ard-wc/kfpd/Hardware/Pictures/Touch Detection Circuit With Multiplexer_Slate.png

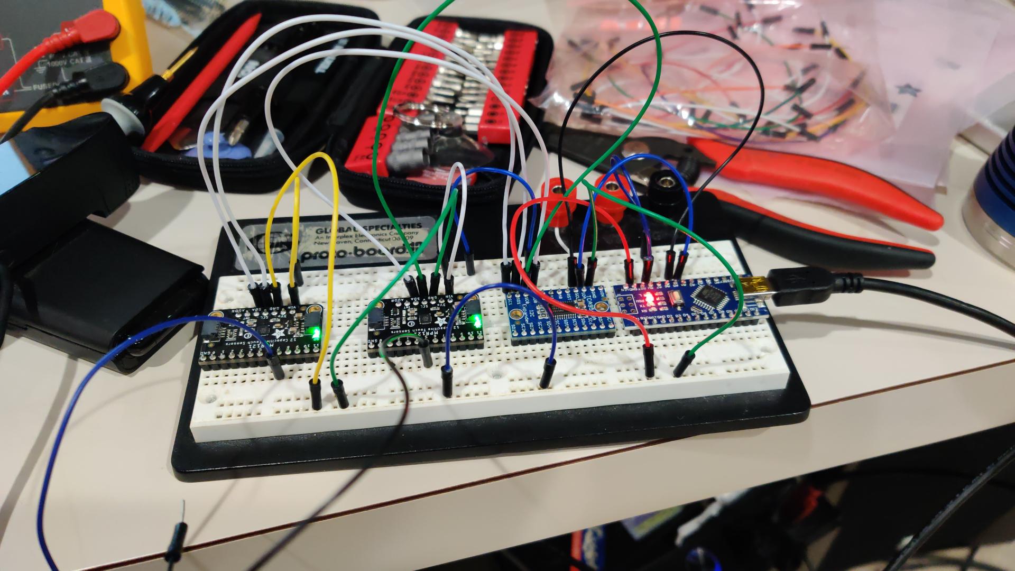
Hardware/Pictures/Touch Detection Circuit With Multiplexer_Slate.png
