ard-wc/kfpd/Hardware/Pictures/Keyboard Case Unmodified_Slate.png

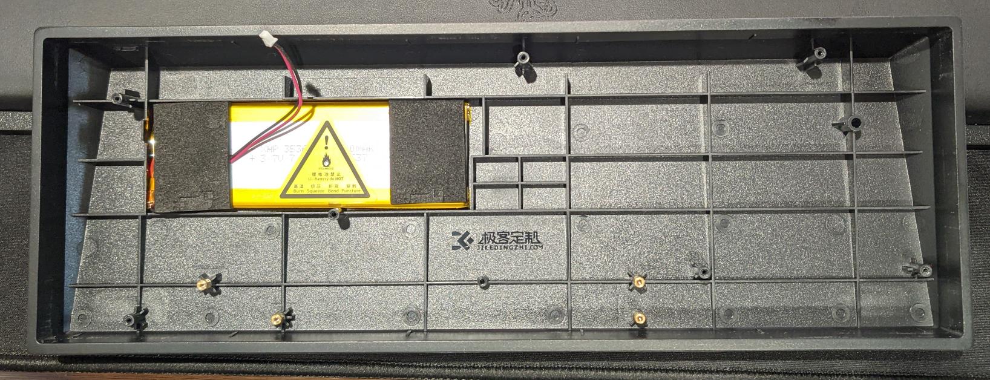
Hardware/Pictures/Keyboard Case Unmodified_Slate.png
