ard-wc/kfpd/README.md

## Table of Contents

Block Diagram

- Keyboard Finger Position Display Block Diagram\_Victor.pdf

Code of Conduct

- EE585-595 Code of Conduct.pdf

Conductive Materials

- Pros and Cons of Different Conductive Materials_Victor_Slate_Chase.pdf

Hardware

- Compartment Sketches &amp; Dimensioning
  - Compartment Design #1 - Victor Siooh.glb
  - Compartment Design #1 - Victor Siooh.png
  - Compartment Design #2 - Victor Siooh.glb
  - Compartment Design #2 - Victor Siooh.png
  - Compartment Design Work\_Victor.pdf
- Components &amp; Datasheets
  - Component_List_Slate.xlsx
  - Component_List_Slate.pdf
  - MPR121\_Technical\_Data\_2010.pdf
  - MPR121\_Technical\_Data\_2013.pdf
  - NanoV3.3\_sch.pdf
  - TCA9548\_Datasheet.pdf
- Pictures
  - Keyboard Case Modified_Slate.png
  - Keyboard Case Unmodified_Slate.png
  - Touch Detection Circuit With Multiplexer_Slate.png
  - Touch Detection Circuit Without Multiplexer_Chase.jpg
- Schematics
  - Official\_Schematic\_KFPD\_Slate.pdf
  - Prototype Schematic\_Victor.pdf
- Testing
  - Combined Data for Testing ADC Counts\_Chase.xlsx
  - Test ADC counts just with 25 ohms\_Chase.csv
  - Test ADC counts just with 50 ohms\_Chase.csv
  - Test ADC counts just with finger\_Chase.csv

Presentations

- Senior Project Design I - Fall Showcase Technical Presentation.pptx
- Senior Project Design I - TechBlazers Midterm Presentation.pptx
- Senior Design Project I Fall Showcase Orientation Video Presentation.pptx

Product Reflection

- Product Reflection Paper - Techblazers.pdf

Project Planning

- Project Planning Paper.pdf

Project Proposal

- Project Proposal.pdf

Prototype Images

- Prototype.jpg
- Hardware Integration (MPR121 Capacitive Touch Sensors and Arduino Nano).jpg

Requirements
- Technical Requirements.pdf

Software

- Application\_Prototype\_Emmitt.py
- Application\_Test\_Emmitt.py
- FrontEndDev\_Chief.pdf
- KFPDapp\_Chief.py
- MPR121_Final.ino
- MPR121\_Multiplexer\_Chase.ino
- MPR121\_print\_ADC\_counts\_Chase.ino
- MPR121\_test\_sensitivity\_Chase.ino
- resize\_test\_Emmitt.py

Specifications

- Technical Product Specifications.pdf

Team Skills

- Team Skills Matrix.xlsx

Technical Journals

- Chase
  - Technical Journal - Senior Design 1\_Chase.pdf
  - Technical Journal - Senior Design 2\_Chase.pdf
- Chief
  - IndividualJournalFall21Chief.pdf
  - TechJournalSDII.pdf
- Emmitt
  - journal2.pdf4
- Slate
  - Individual Technical Journal.pdf
- Victor
  - Journal Entry #1.pdf
  - Journal Entry #2.pdf
  - Journal Entry #3.pdf
  - Journal Entry #4.pdf
  - Journal Entry #5.pdf
  - Journal Entry #6.pdf
  - Journal Entry (01_24_22 – 02_06_22).pdf
  - Journal Entry (02_13_22 - 02_27_22).pdf

Videos
  - Prototype Demonstration Video.mp4
  - Product Orientation Video.mp4

Weekly Minutes
  - EE585-595\_weekly minutes (09\_05\_21).docx
  - EE585-595\_weekly minutes (09\_12\_21).docx
  - EE585-595\_weekly minutes (09\_19\_21).docx
  - EE585-595\_weekly minutes (09\_26\_21).docx
  - EE585-595\_weekly minutes (10\_03\_21).docx
  - EE585-595\_weekly minutes (10\_31\_21).docx
  - EE585-595\_weekly minutes (11\_14\_21).docx
  - EE585-595_weekly minutes_02_06_22.docx
  - EE585-595_weekly minutes_02_20_22.docx

Work Packages (Individual)
  - Work Package_Slate.pdf
  - Individual Work Package - Victor Siooh.pdf
  - Individual_Work_Statment_Emmitt.pdf
  - Work Package_Chase.pdf
  - IndividualWorkPackage_Chief.pdf

Work Statement
  - Senior Design Project II - 2nd Semester Work Statement.pdf
