ard-wc/kfpd/Project Completion/Deliverables/Wire Connections Between Hardware Devices.pdf

The connections between the devices are outlined below.
- Vin
o Connect all sensors and multiplexer to 5V node from Arduino Nano
- GND
o GND on multiplexer goes to GND on Nano all the capacitive sensors are connected to
- SDA
o SDA on multiplexer connects to A4 on Nano
- SCL
o SCL on multiplexer connects to A5 on Nano
- SDN
o Connect SDN on the first three sensors to SD0 on the multiplexer
o Connect SDN on the second three sensors to SD1 on the multiplexer
- SCN
o Connect SCN on the first three sensors to SC0 on the multiplexer
o Connect SCN on the second three sensors to SC1 on the multiplexer
