ard-wc/kfpd/Hardware/Schematics/Prototype Schematic_Victor.pdf

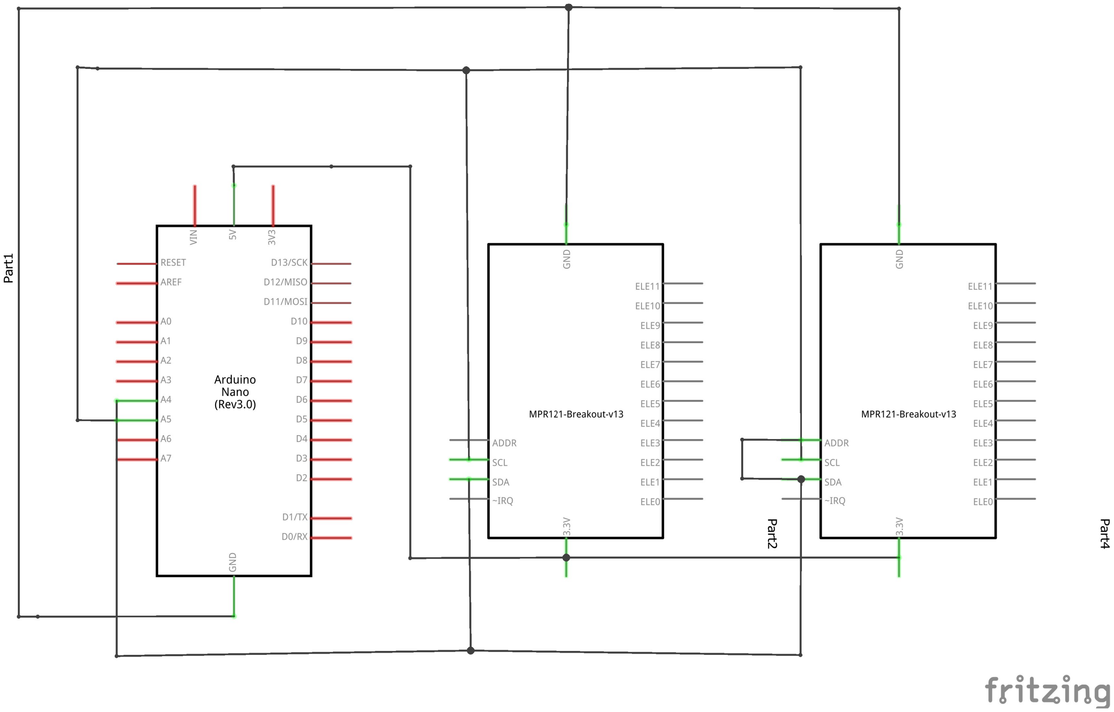
[picture p15: figure]
