ard-wc/kfpd/Hardware/Compartment Sketches & Dimensioning/Compartment Design #2 - Victor Siooh.png

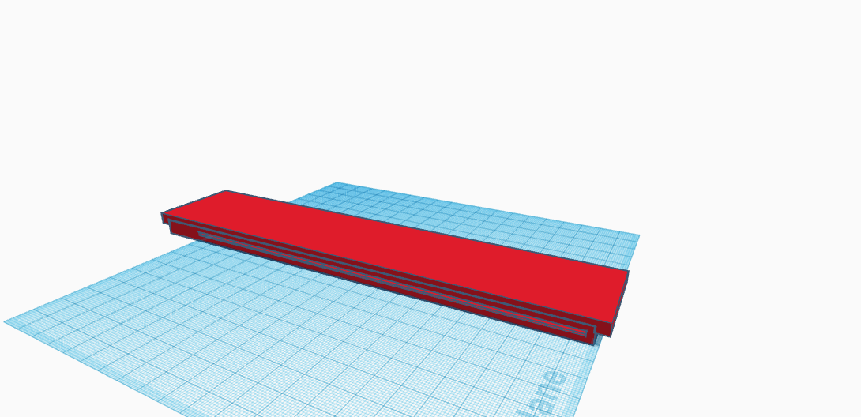
Hardware/Compartment Sketches & Dimensioning/Compartment Design #2 - Victor Siooh.png
