ard-wc/kfpd/Hardware/Pictures/Keyboard Case Modified_Slate.png

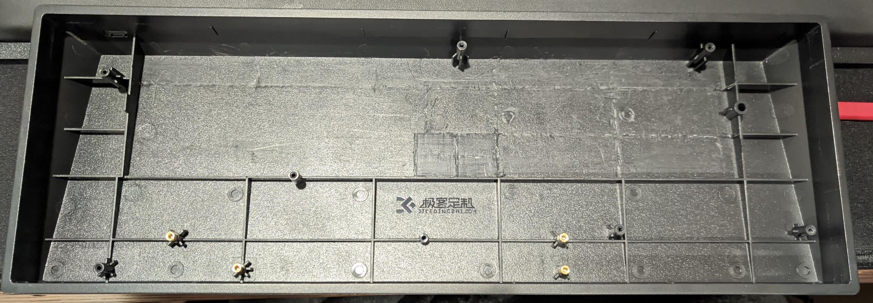
Hardware/Pictures/Keyboard Case Modified_Slate.png
