ard-wc/kfpd/Project Completion/Deliverables/Compartment Design #1 - Victor Siooh.png

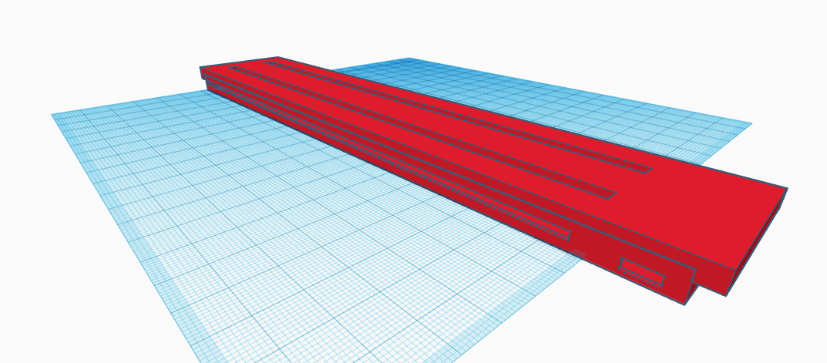
Project Completion/Deliverables/Compartment Design #1 - Victor Siooh.png
