ard-wc/kfpd/Prototype Images/Hardware Integration (MPR121 Capacitive Touch Sensors and Arduino Nano).jpg

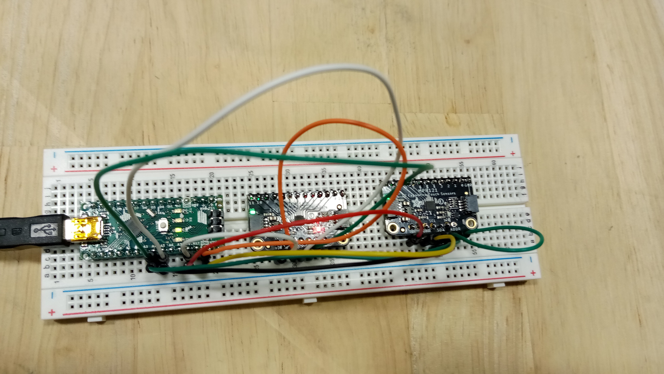
Prototype Images/Hardware Integration (MPR121 Capacitive Touch Sensors and Arduino Nano).jpg
