ard-wc/kfpd/Prototype Images/Prototype.jpg

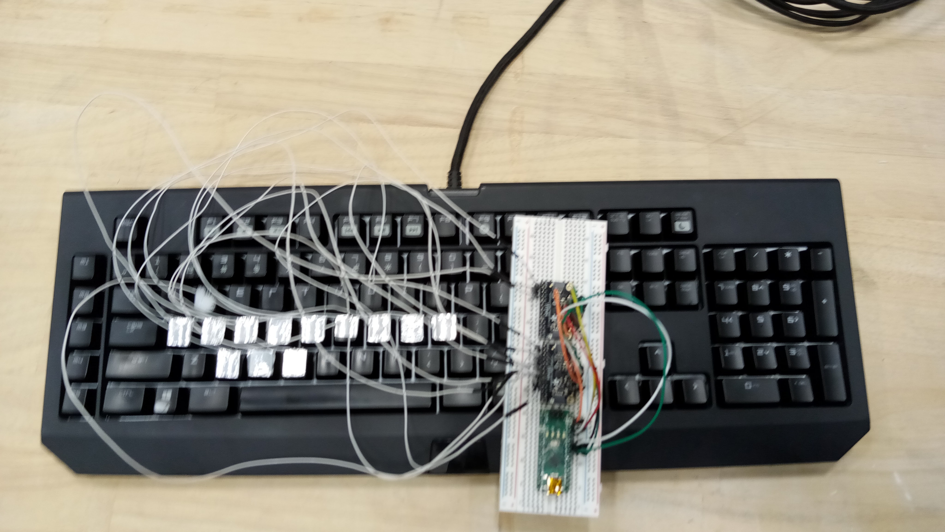
Prototype Images/Prototype.jpg
