ard-wc/kfpd/Project Completion/Deliverables/Component_List_Slate.pdf

Component Description | Model Number | Manufacturer Quantity
12-Key Capacitive Touch Sensor | MPR121 | Adafruit | 6
I2C Multiplexer | TCA9548A | Adafruit | 1
Microcontroller | ATmega328 (Nano) | Arduino | 1
Switches | ks-9 brown | Gateron | 63
Keyboard (Case and PCB) | GK61xs | Skylong | 1
I2C Qwiic Conectors | JST SH 4-pin | Adafruit | 6
Conductive Coating Silver/Copper | 843AR | MG Chemicals | 1
30AWG Silicone Wire | N/A | BNTECHGO | 61 (wires)
Keycaps | Black 104/105 | Razer | 1
