ard-wc/kfpd/Project Completion/Deliverables/KeyPressTestCase.docx

Document will show a table indicating available keys on the keyboard, and whether the correct key was shown in the on-screen keyboard when pressed on.

Key | Pass/Fail | Key | Pass/Fail
Esc | Pass | D | Pass
1 | Pass | F | Pass
2 | Pass | G | Pass
3 | Pass | H | Pass
4 | Pass | J | Pass
5 | Pass | K | Pass
6 | Pass | L | Pass
7 | Pass | ; | Pass
8 | Pass | ‘ | Pass
9 | Pass | Enter | Pass
0 | Pass | Shift (Left side) | Pass
- | Pass | Z | Pass
= | Pass | X | Pass
Backspace | Pass | C | Pass
Tab | Pass | V | Pass
Q | Pass | B | Pass
W | Pass | N | Pass
E | Pass | M | Pass
R | Pass | , | Pass
T | Pass | . | Pass
Y | Pass | / | Pass
U | Pass | Shift (Right side) | Pass
I | Pass | Ctrl (Left side) | Pass
O | Pass | Win | Pass
P | Pass | Alt (Left side) | Pass
[ | Pass | Spacebar | Pass
] | Pass | Alt (Right side) | Pass
\ | Pass | Menu | Pass
Caps Lock | Pass | Ctrl (Right side) | Pass
A | Pass | Fn | Pass
S | Pass
