ard-wc/kfpd/Project Completion/Deliverables/Combined Data for Testing ADC Counts_Chase.xlsx

Sheet: Data Summary
Added Resistance | Average Baseline ADC counts (No Touch) | Average Filter ADC counts (No Touch) | Difference (No Touch) | Average Baseline ADC counts (Touch) | Average Filter ADC counts (Touch) | Difference (Touch) | Average Baseline ADC counts (Touch-No Touch) | Average Filter ADC counts (Touch-No Touch)
50 ohms | 224 | 226 | 2 | 222 | 59 | 163 | 2 | 167
25 ohms | 236 | 236 | 0 | 235 | 52 | 183 | 1 | 184
0 ohms | 278 | 282 | 4 | 276 | 60 | 216 | 2 | 222

Sheet: 50 ohms
ID | ADC Value
3b | 224
3f | 225
3b | 224
3f | 227
3b | 224
3f | 225
3b | 224
3f | 227
3b | 224
3f | 226
3b | 224
3f | 227
3b | 224
3f | 225
3b | 224
3f | 226
3b | 224
3f | 226
3b | 224
3f | 224
3b | 224
3f | 224
3b | 220
3 | 1
3f | 58
3b | 220
3f | 58
3b | 220
3f | 59
3b | 220
3f | 57
3b | 220
3f | 55
3b | 220
3f | 57
3b | 220
3f | 57
3b | 220
3f | 52
3b | 220
3f | 55
3b | 220
3f | 53
3b | 220
3f | 53
3b | 220
3f | 56
3b | 220
3f | 58
3b | 224
3 | 0
3f | 226
3b | 224
3f | 225
3b | 224
3f | 226
3b | 224
3f | 227
3b | 224
3f | 226
3b | 224
3f | 226
3b | 224
3f | 225
3b | 224
3f | 227
3b | 224
3f | 226
3b | 224
3f | 225
3b | 224
3f | 226
3b | 224
3f | 226
3b | 224
3f | 225
3b | 224
3f | 226
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
