ard-wc/kfpd/Technical Journals/Victor/Journal Entry #3.pdf

Journal Entry #3 (09/27 – 10/01)

Objective: Research over capacitive sensing

Introduction to Capacitive Sensing:

Capacitive Sensors:

How Capacitive Touch Through Metal Works: https://www.youtube.com/watch?v=bokWXzVXsyc&ab_channel=TexasInstruments

This video details some of the benefits of having capacitive touch through metals.

- Touch through metal is apparently waterproof
- Operates well while using gloves
- Dirtproof

Arduino with Capacitive Touch Sensors: https://www.youtube.com/watch?v=Jt2yZMGCQBQ&t=45s&ab_channel=BasonTech

Materials required: Jumper wires, Arduino Uno, and capacitive touch sensors

- Capacitive touch sensors could be integrated to the keyboard beneath the keycaps.
- We would have to figure out how the keyboard would detect the touch sensors as an input
- This option may not be the best aesthetically since so many wires would be used for each key

How Capacitive Touch Screens Works: https://www.youtube.com/watch?v=BR4wNq6WGkg&ab_channel=TomHebb

- C = EA/d
- A capacitor can be made with two conductors

DIY Capacitor: https://www.youtube.com/watch?v=BR4wNq6WGkg&ab_channel=TomHebb

- Homemade capacitor (paper,foil,paper,foil,paper)
- Aluminum and paper are cheap materials to purchase
- Capacitance of our capacitor can be determined using capacitance formula
- We can use aluminum as our conductive plates and

USB Keyboards with Cherry MX Keycaps:

Logitech G610 Orion Red Backlit Mechanical Gaming Keyboard

https://www.amazon.com/Logitech-Backlit-Mechanical-Gaming-Keyboard/dp/B01CDYB8AG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 (https://www.amazon.com/Logitech-Backlit-Mechanical-Gaming-Keyboard/dp/B01CDYB8AG)

Mechanical Gaming Keyboard, MageGee 2021 New Upgraded Blue Switch 104 Keys White Backlit Keyboards, USB Wired Mechanical Computer Keyboard for Laptop, Desktop, PC Gamers(White & Blue)

https://www.amazon.com/Mechanical-Keyboard-MageGee-Upgraded-Keyboards/dp/B087P7153D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 (https://www.amazon.com/Mechanical-Keyboard-MageGee-Upgraded-Keyboards/dp/B087P7153D?s=electronics)

ard+blue&qid=1633312887&s=electronics&sprefix=mechanical+keyboard+b%2Celectronics%2C505&sr= 1-4 (https://www.amazon.com/Mechanical-Keyboard-MageGee-Upgraded-Keyboards/dp/B087P7153D?s=electronics)

Mechanical Gaming Keyboard Full Size, Bllean LED Rainbow Backlit Ultra-Slim Wired Keyboard with Blue Switches, Full-Key Rollover, Ergonomic Water-Resistant USB Keyboard for Windows Mac Gaming

https://www.amazon.com/dp/B09D3DDQ99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 wODg4MjMzMlRDVFgyS0pDU0VQUSZlbmNyeXB0ZWRBZElkPUEwOTk0ODA1OUtKSzRTOEFDR1RaJndpZG dldE5hbWU9c3BfZGV0YWlsJmFjdGlvbj1jbGlja1JlZGlyZWN0JmRvTm90TG9nQ2xpY2s9dHJ1ZQ== (https://www.amazon.com/dp/B09D3DDQ99)

Capacitive Touch Sensing Being Used in Midi Keyboards

https://www.nime.org/proceedings/2012/nime2012_195.pdf
