ard-wc/kfpd/Technical Journals/Slate/Individual Technical Journal.pdf

# Individual Technical Journal

Senior Design

Slate Jordan

## Week of September 5th

-11th

Summary

This week our team struggled to find an idea that met all our criteria. We tentatively decided on my idea for an automatic pothole reporting device, however, more research yielded AI with cameras to be the best approach which doesn’t give our EE team members much hardware work. Considering this we switched to our backup Evergy sponsored idea of QR Code labeling and database integration. Our concerns about not enough work were verified in class and we were back at square one with no project ideas left. Eventually we settled upon an idea from our meeting with the professor.

Focus of the week

This week involved lots of research on various ideas we had. The main problem with my first idea was the work involved for a solution being mostly software which isn’t ideal for our team. Our backup idea was never ideal and was mainly used as a placeholder after we ran out of time between nixing the first idea and presenting on Friday. The current plan is to go with a local license plate scanner and reader which uses the LoRaWAN network to communicate findings back to police stations. Currently I am researching existing solutions commonly called LPR or license plate readers to find out if our solution can be unique enough to differentiate it from existing solutions.

## Week of September 12th

-18th

Summary

We were still struggling with our project idea this week, so the majority of my time was spend researching and thinking about projects. We had multiple team meetings and communication about the validity of ideas. The ALPR (Automatic License Plate Reader) idea was slowly falling apart after much research into existing technologies revealed many solutions already on the market with capabilities that met our requirements.

Research

My research led me to various existing ALPR devices and software. I will use platerecognizer.com as an example. It supports both on-device and cloud software, images, and video, as well as non-ideal angles, lighting, resolution, etc. With all this being considered I concluded that anything we would be able to build with our limited resources and time would not have any competitive advantage with the main aim of our ALPR solution being the ability to read plates at angles.

Some Resources

https://github.com/openalpr/openalpr

https://www.openalpr.com/

https://platerecognizer.com/

## Week of September 19th

-25

th

Summary

Our team was still toying with a few ideas like building a map of traffic and speed cameras using computer vision to give drivers the knowledge of where these controversial traffic cameras are located. Eventually we settled on a keyboard with the ability to detect finger placement. This would in theory speed up the process of learning how to touch type. Our initial idea to enable the sensing of finger placement is capacitively sensitive keycaps. We would also have software to give an on-screen representation of finger placement thus discouraging the habit of looking down at the keyboard. The problem: some people have trouble learning touch typing and breaking the habit of constantly looking down at the keyboard. The solution: A keyboard with touch sensitive keys and an on-screen overlay showing which keys are being touched.

Research/Thoughts

My initial idea on how to sense key touches was to have the keys be capacitive. I thought of the clever Oculus Rift controllers which have capacitively sensitive buttons and triggers to show in a virtual environment where your fingers were currently resting. As is the case with many technologies, the original purpose is not always the best use so with that in mind I am still brainstorming other possible use cases for this extra layer of input being enabled on a keyboard. Another idea for the tracking the position of fingers above the keyboard was some type of sensor(s) to track the x-y position, but we think capacitive keys is the clear first step with that being something to consider later in the development process. Using a keyboard with standard Cherry MX style key caps will allow us to switch keycaps out as we go forward with testing.

Resources

https://www.youtube.com/watch?v=wdgULBpRoXk

https://www.youtube.com/watch?v=mWR9Q_pTagw

https://www.youtube.com/watch?v=bokWXzVXsyc

https://www.nelson-miller.com/capacitive-switch-work/

http://www.pcbheaven.com/wikipages/How_a_Touch_Button_works/?p=1

https://butlertechnologies.com/basics-capacitive-touch/

## Week of September 26th - October 2

nd

Summary

My focus for this week was to find out as much as I could about affordable and small capacitive sensing hardware. Something small enough we could incorporate into a keyboard as well as interface with windows via USB.

Research Findings

An Arduino stood out as the clear choice for microcontroller for all our capacitive inputs and interfacing with the computer. A combination of the broad userbase and resources and hardware addons available for Arduinos make for a nice fit. Specifically, the Arduino nano model is ideal for its small form factor. For the capacitive sensing of so many keys it is impractical to directly attach them to an Arduino. This means some intermediary controller/input device is needed to take all 18 or so inputs. The clear choice for this was the Adafruit 12-Key Capacitive Touch Sensor Breakout - MPR121 for it’s 12 capacitive inputs as well as built in sensitivity adjustment and noise filtering for only $8.

Resources

https://www.adafruit.com/product/1982

https://store.arduino.cc/products/arduino-nano

https://create.arduino.cc/projecthub/gatoninja236/capacitive-touch-sensing-grid-f98144

## Week of October 3

nd
- 9

th

Summary

I didn’t do much in the way of technical research this week with our midterm presentation coming up. I helped work on the presentation as well as brainstorm use cases for our keyboard as well as some routes we could take with the software.

Resources

https://windowtop.info/

https://docs.oracle.com/cd/E19683-01/816-0279/transpoverlay-63475/index.html

https://polycount.com/discussion/89191/image-always-on-top-overlay-software-for-win

https://softwarerecs.stackexchange.com/questions/1767/display-half-transparent-ghostimage-over-other-windows (https://softwarerecs.stackexchange.com/questions/1767/display-half-transparent-ghost-image-over-other-windows)

https://www.mobzystems.com/tools/seethroughwindows/

## Week of October 10th

- 16th

Summary

This week we continued the theme of brainstorming and researching problems or demographics of people which could benefit from our keyboard. I also researched and found a keyboard which met our requirements of price, size, switches, and quality. In addition, I had a breakthrough idea on how to easily operate the Arduino USB connection over the same keyboard cable.

Ideas

In my research on how to easily operate two USB connections over the existing keyboard cable without interfering with standard keyboard operations, I had an idea to easily overcome the challenge. After seeing keyboards with built in USB pass through ports, It was clear that we could start with a keyboard that had a USB pass through port built in. This would allow us to easily tap into the pass through and connect our Arduino via USB with no changes to the existing keyboard design or function.

## Week of October 17th

- 23rd

Summary

My focus for this week was mostly on hardware and getting more specific requirements and specifications. I’ve made the selection of silicone insulated wire for our keyboard wiring due to its high flexibility which should minimize interference with keys. From looking over our keyboard, space inside the chassis is limited so my initial thoughts are we might have to find a different keyboard or modify the bottom plate to make room for our parts. Our team’s technical report was also a big focus for this week and incorporated the research done.

Resources

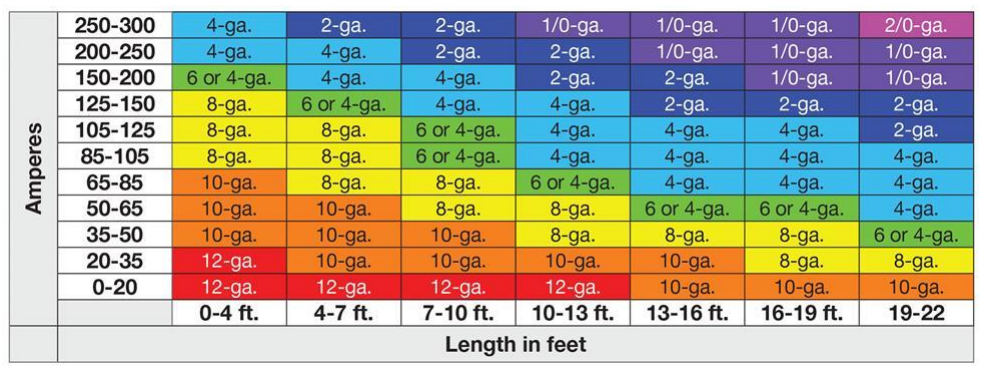
[picture p60: figure]

https://www.ql-custom.com/what-is-silicone-wire-performance-benefits-and-uses-withexamples.html (https://www.ql-custom.com/what-is-silicone-wire-performance-benefits-and-uses-with-examples.html)

https://www.meridiancableassemblies.com/2021/04/wire-gauge-size-guide/

## Week of October 24th

- 30th

Continued the planning of our prototype. Also continued working on other possible uses for the extra layer of input enabled by our capacitively sensitive keys. We continue to have the problem of what the best use case or use market is. One option to enhance the touch typing learning experience with our keyboard is to detect which finger is on a certain key. The ability to distinguish between fingers will allow our program to analyze one’s typing habits and report on how to improve form and in turn increase typing efficiency and speed. This might be enabled by doing an initial calibration for an individual user’s fingers if our capacitive system is sensitive enough to detect the subtle change in capacitances. Another option to enhance this capability would be to incorporate a camera which could augment the capacitive sensors in distinguishing between fingers. VR application is already using a similar type of computer vision to recognize the keyboard and relative hand position, although it is currently not the most accurate which is where our capacitively augmented system would be superior.

## Week of October 31

st

## - November 6th

Summary

This week was the first time we had some hardware to test out. We had the Arduino Nano and MPR121 sensor boards in hand for initial testing. Along with that testing I researched communication protocols for serial busses utilized by the Arduino and devices which turned out to be the I2C protocol. although our priority is getting a working prototype, we also did some physical work with the keyboard like disassembling it and planning the placement of our components just to keep that in the back of the mind.

Resources

https://learn.sparkfun.com/tutorials/i2c/all

https://forum.arduino.cc/t/multiple-mpr121-capacitive-sensors-addresses-andinstallation/453518 (https://forum.arduino.cc/t/multiple-mpr121-capacitive-sensors-addresses-and-installation/453518)

https://forum.seeedstudio.com/t/12-key-capacitive-i2c-touch-sensor-v2-mpr121-multipleboards/252121 (https://forum.seeedstudio.com/t/12-key-capacitive-i2c-touch-sensor-v2-mpr121-multiple-boards/252121)

https://arduino.stackexchange.com/questions/17738/mpr121-multiple-using-breakout

https://files.seeedstudio.com/wiki/Grove-I2C_Touch_Sensor/res/Freescale_Semiconductor;MPR121QR2.pdf (https://files.seeedstudio.com/wiki/Grove-I2C_Touch_Sensor/res/Freescale_Semiconductor;MPR121QR2.pdf)

## Week of November 7

th

- 13th

Summary

This week I was mainly focused on testing our Arduino/Sensor combo functionality. I got the necessary components soldered to the sensor breakout boards to test multiple devices over the I2C bus which is used by the sensors to communicate with the Arduino.

Discussion

The I2C protocol uses aspects from both Universal asynchronous receiver-transmitter (UART) and Serial Peripheral Interface (SPI). It uses only two wires to communicate Serial Data (SDA) and Serial Clock (SCL) which is nice. It works by having a master (the Arduino) and slave devices (MPR121’s) which is nice for multiple devices on a single communication link and wire. The MPR121 boards allow four different addresses to be selected for differentiating between devices on the I2C connection. This means we can have up to four MPR121’s connected to a single Arduino allowing for up to 48 individual capacitive touch inputs. This number was plenty up until we started doing some thinking about certain edge cases with our planned grid layout. The grid layout would theoretically work great with some data manipulation and thresholds in out software, until n-key rollover is desired or a lack of sensitivity from the hardware. Consider the simple case of all eight fingers on the home row. In this scenario the input connected to the home row would be activated at some capacitance, and the eight inputs connected to the corresponding column would be activated. If your first finger were to move from the J key to the u key then the single row sensor would need to have the capability to distinguish between the capacitance of eight fingers on that row and seven in order to properly display what keys were being touched. There might be other ways to get around this issue like implementing software which is smart enough to know a there should only be eight keys activated at a given time, but with accuracy and complexity in mind, we concluded that we should have a dedicated touch input per key for maximum accuracy and reliability. With the grid layout, connecting 61 keys only required up to 2 MPR121 boards, however, if each key is individually connected to a touch sensor input, we would require a full 61 inputs exceeding the 48 maximum per Arduino. We will now have to resort to the use of a multiplexer or similar device to have enough touch inputs with one Arduino.

Resources

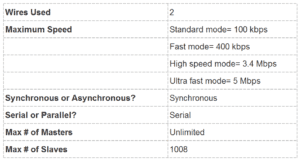
[picture p61: figure]
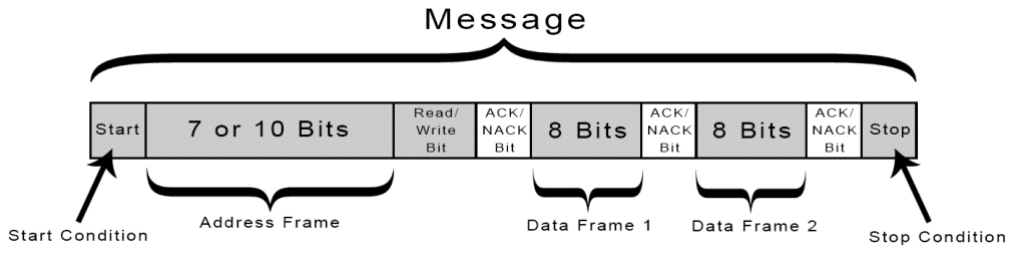
[picture p62: figure]

https://www.circuitbasics.com/basics-of-the-i2c-communication-protocol/

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

# Second Semester

## To February 13

th

Summary

Beginning the semester with all the parts I had ordered at the end of last semester, I had quite a few items to setup before doing any testing. The testing priority for me was verifying the viability off copper tape placed under the keycap.

Discussion

Last semester we ended with our prototype running with aluminum tape on top of keycaps to have direct contact with the conductive surface. Now that we had the correct copper tape which accepts soldering (aluminum oxidizes so fast it is nearly impossible to solder to) I could test if our sensor equipment was sensitive enough to have indirect touch sensing. After setting up everything I measured about a 10-count difference when indirectly sending compared to a 50-count delta with direct touch. This showed our sensors could work with thee right calibration.

We were also grappling with the problem of how and where to route and attach all the wires. We have come up with a few ideas to route a wire up through the actual key switch which would make a much cleaner routing of wires. In the picture below a hole could be drilled into the bottom of the center coloumn of the switch which a wire could be routed through. Then connecting the wire to the bottom of the stem (second picture) which would be coated in a conductive coating. This would allow the switch cap to be connected to the wire. Still a work in progress but so far it seems promising.

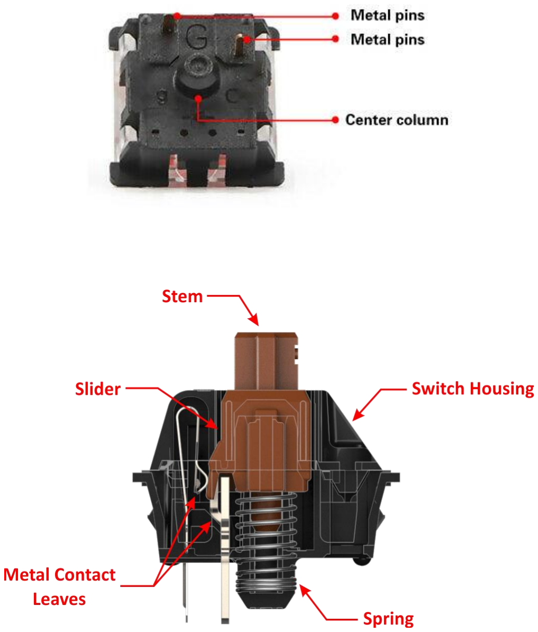
[picture p63: figure]

## February 13th – 27th

Summary

Quite a few things were happening this period. First, I researched and ordered the keyboard we will use which has swappable switches. This is important for our plan to get a conductive path to the keycap. Second, I prepped the hardware for final testing before starting building including initial testing of the multiplexer connected with daisy chained sensors. Third, I researched and ordered a conductive coating spray we are planning to use. Fourth, I researched and ordered some of the last materials we will need to build our final product. Fifth, I started designing the layout of our hardware inside the keyboard after receiving it. Sixth, I designed the final hardware schematic. Seventh and finally I did some more thinking about the possible solution to making a conductive path from underneath the keyboard PCB to the keycap.

Discussion

1. The full-size keyboard we have been planning on using had one issue that started coming to light as we continued to develop our plan to route wiring to the keys. That issue being soldered PCB mounted switches. They keyboard I found has a hot-swappable PCB for easy removal and modification of the switches. In relation to this, I also ordered Gateron Brown switches which give tactile feedback when pressed and are a standard Cherry MX style.
2. The prepping of hardware was mostly straightforward. One notable decision was to only attach three sensors to two of the multiplexer ports. This will allow the sensors to be daisy-chained to maximize space efficiency and minimize wiring.
3. Our team settled on trying to use a conductive spray coating as the intermediary conductor from the wire to the keycap. I found the brand MG Chemicals who make four different options for conductive spray coatings. These sprays are also advertised to adhere well to most injection molded plastics which fits our application well. Carbon was immediately counted out for its higher surface conductivity compared to the other three. Next nickel was discarded from the running due to nickel being considered a human carcinogen. So, with the choice being between Silver-coated copper and just silver, the former was the clear option due to the significantly lower cost with similar properties like conductivity. Below is a comparison chart.

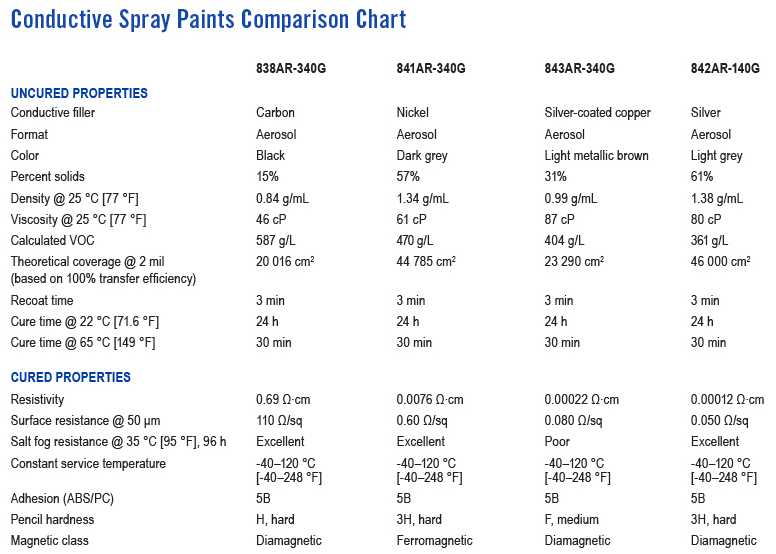
[picture p64: figure]

Silver-Coated Copper:

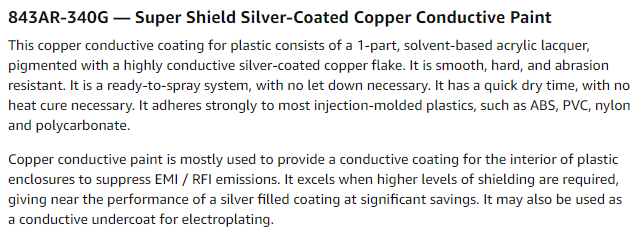
[picture p65: figure]

To show why a lower resistance is favorable I will use this illustration of how the capacitive touch sensor measured the change in capacitance to sense a touch. In short, the touch sensor applies a charge current I over a period of time T then measures the voltage V as shown in the graph. The lower the voltage, the lower the ADC count value and greater the difference between baseline and reading. The next picture shows the equation of how capacitance, charge, current, time, and voltage relate. Another important attribute of the MPR121 is that it uses a constant DC charge current scheme for capacitance measurement. With all this information resistance shouldn’t affect the capacitance readings because the sensor should automatically adjust voltage to keep a constant charge current over the specified charge time. This only works to a certain point though because the constant current supply can theoretically only supply a certain maximum voltage. This is my current theory. Given this It is my opinion that we pick the lowest resistance conductive spray for efficient operation.

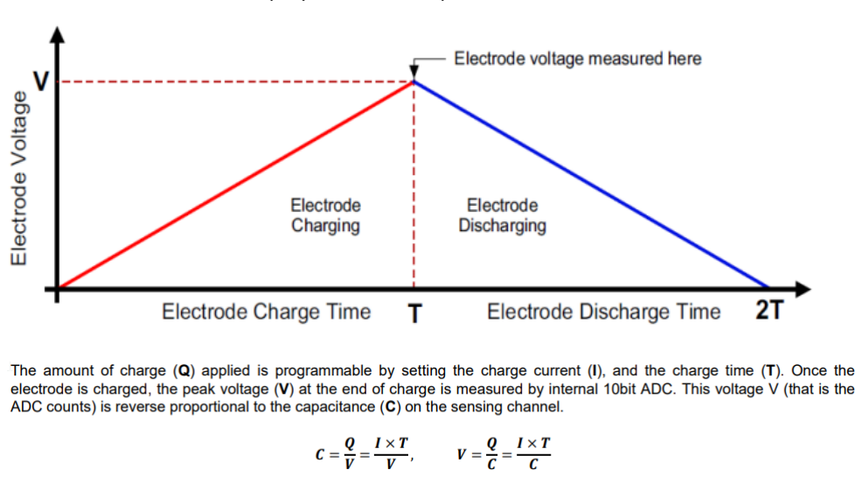
[picture p66: figure]

4. Nothing much to cover on ordering the last materials. I found some lead free solder wick for disassembling pins on our Arduino and sensors for final assembly. Also found some multi color wire for when we assemble to provide easier troubleshooting rather than having 61 wires all the same color.
5. We are working with limited space inside the keyboard case since it is a 60 percent keyboard. With 8 pieces of hardware needing to be fit, I looked at some potential layouts inside the case keeping in mind the Arduino’s USB port needing to have an access hole cut on the back. The case has some support fins which I am planning on taking out to provide space for sensors (see picture). Since the case has a tilt, the rear will have more space so that is where the hardware will reside. see picture for rough layout. As I mentioned earlier two groups of three daisy-chained sensors will allow for less wiring.

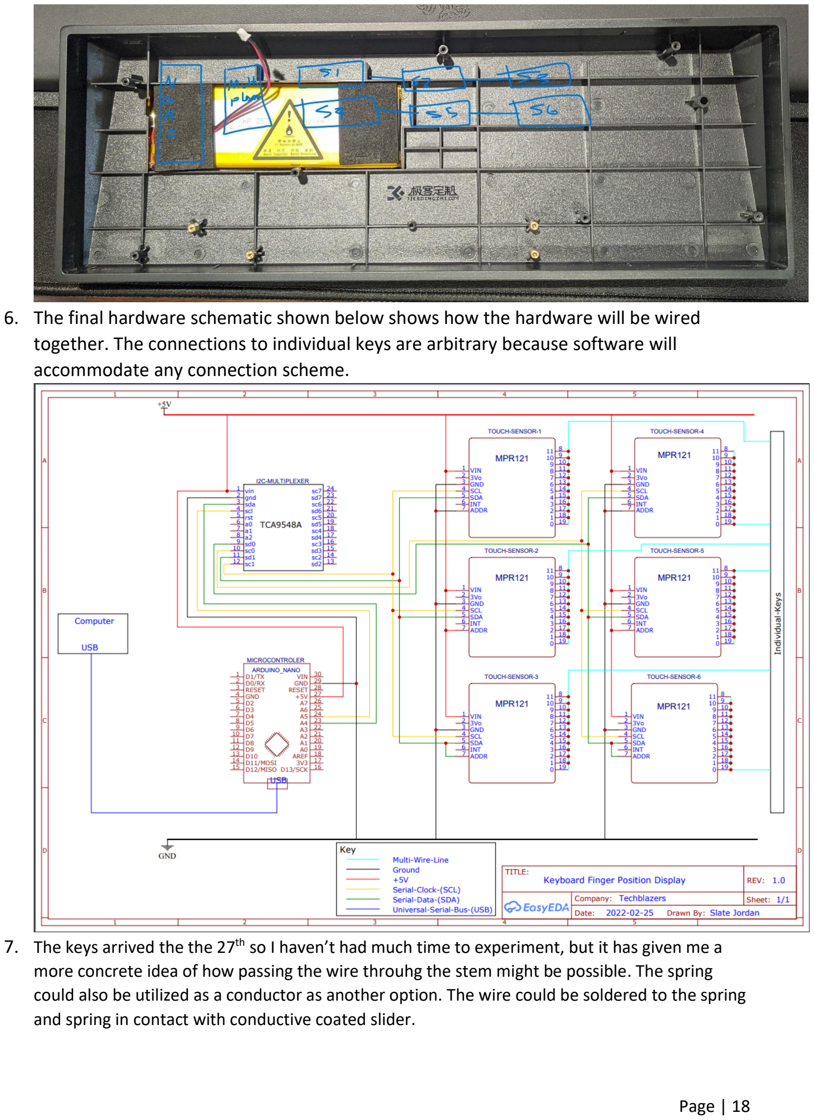
[picture p67: page 19]

6. The final hardware schematic shown below shows how the hardware will be wired together. The connections to individual keys are arbitrary because software will accommodate any connection scheme.
7. The keys arrived the the 27th so I haven’t had much time to experiment, but it has given me a more concrete idea of how passing the wire throuhg the stem might be possible. The spring could also be utilized as a conductor as another option. The wire could be soldered to the spring and spring in contact with conductive coated slider.
