ard-wc/kfpd/Technical Journals/Chief/TechJournalSDII.pdf

Chief Boateng | Individual Journal | 02/27/22

First Weekly Journal (01/30/22 – 02/05/22)

General Notes:

Took the time to research into different software development tools for app development, some which included Flutter, Swift and Visual studios. I looked into the coding languages of each and whether they may be compatible with the software requirements of our project. In addition, I sampled different log in screens from different websites and applications to get some idea on what the projects’ application log in screen may look like and added it into the draft of the design of the application page with its contents.

Drafted contents of the application:

Front Page (Login Page)

- (Image portraying the app?)
- Login Credentials
- Entering a username/email
- Entering a password
- Managing Credentials
- Create account (For new users)
- Forgotten password/Change password (For existing users)
- Completed registration/login information
- Continue button

Summary of Contribution

-Began research on software development tools for front end development of the application

-Began brainstorming for a draft of the design of the front page of the application

Second Weekly Journal (02/06/22 – 02/13/22)

General Notes:

Continued research on the development tools to use for the software application development. Began looking over a Microsoft windows app development document containing guides for development using different development templates such as .NET and UWP. Ran A simulation on visual studios 2019 to observe what the display of an application would look on a ‘Hello World’ program. Completed the design for the login page of the application design and met with team members to discuss the design I had.


Summary of Contribution:

-Completed Draft design for the login page of the application design and presented to team members

-Continued researching on development tools to use to design the application

Third Weekly Journal (02/14/22 – 02/20/22)

General Notes

Final decision was made to develop the application page using python since the keyboard code was developed also in python for simplicity. Began going through tutorial documents for the Microsoft visual studio of the front page of the User interface with visual studio.

Summary Of Contribution

- Final decision to use Python to develop app page rather than C++
- Began working on tutorial documents to understand how to develop the python code in Visual studio

Fourth Weekly Journal (02/21/22 – 02/27/22)

General Notes

Noticed an issue in installing Iron Python, which was a requirement for desktop application development in Visual Studio 2019. The Iron Python environment on Visual Studios had gone out of support. I redid some research in finding other dev tools to work on the requirements. Downloaded Python environment ‘Python IDLE’ to be used within Visual Studio Code, making use of Tkinter import library to work on the GUI features of the app on the front end. Completed the steps approach which would be used in order to complete design of the front page. The lines with ‘**’ are steps which may or may not be added.

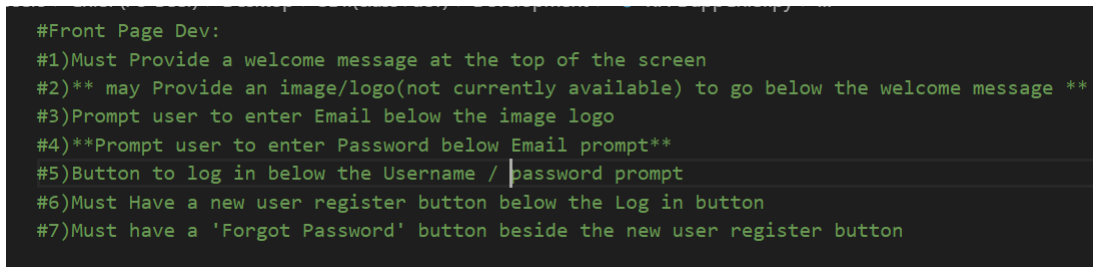
[picture p69: figure]

Summary of Contribution

-Realized issue with code development using Visual Studio with the Iron Python installer being out of support

-Re did some research to find other software development tools which could use python to design GUI

-Downloaded Python IDLE and used it to begin code development of the app, using Visual Studio Code and importing library Tkinter

-Completed the approach which will be used in completing front-page of the app
