ard-wc/kfpd/Project Completion/Deliverables/Official_Schematic_KFPD_Slate.pdf

## TCA9548A

MPR121 | MPR121

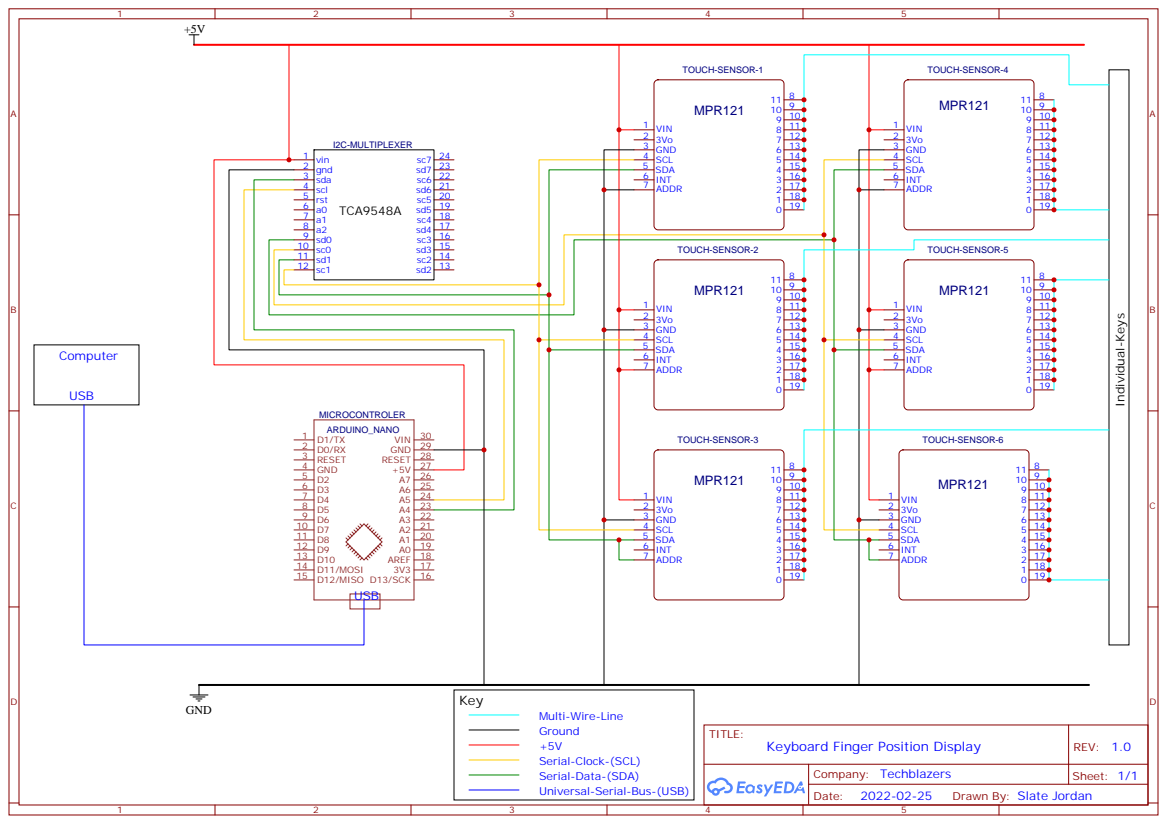
[picture p70: page 1]

Multi-Wire-Line
Ground
Serial-Clock-(SCL)
Serial-Data-(SDA)
Universal-Serial-Bus-(USB)

Drawn By: Slate Jordan
