ard-wc/kfpd/Block Diagram/Keyboard Finger Position Display Block Diagram_Victor.pdf

# Touch Detecting Keyboard and Finger Position Display

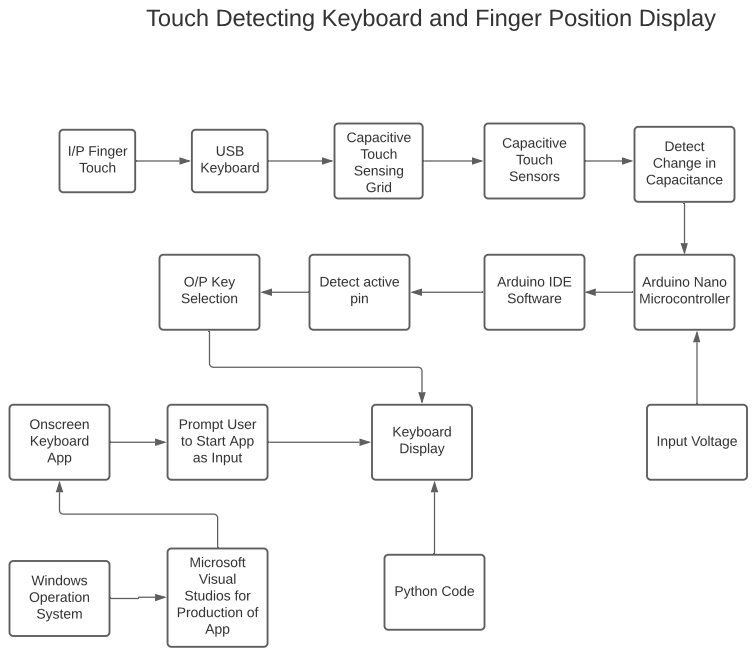
[picture p71: page 1]
I/P Finger Touch; USB Keyboard; Capacitive Touch Sensing Grid; Capacitive Touch Sensors; Detect Change in Capacitance; Arduino Nano Microcontroller; Arduino IDE Software; Detect active pin; O/P Key Selection; Onscreen Keyboard App; Windows Operation System; Microsoft Visual Studios for Production of App; Keyboard Display; Python Code; Input Voltage

Prompt User
to Start App
as Input
