ard-wc/kfpd/Technical Journals/Emmitt/journal2.pdf

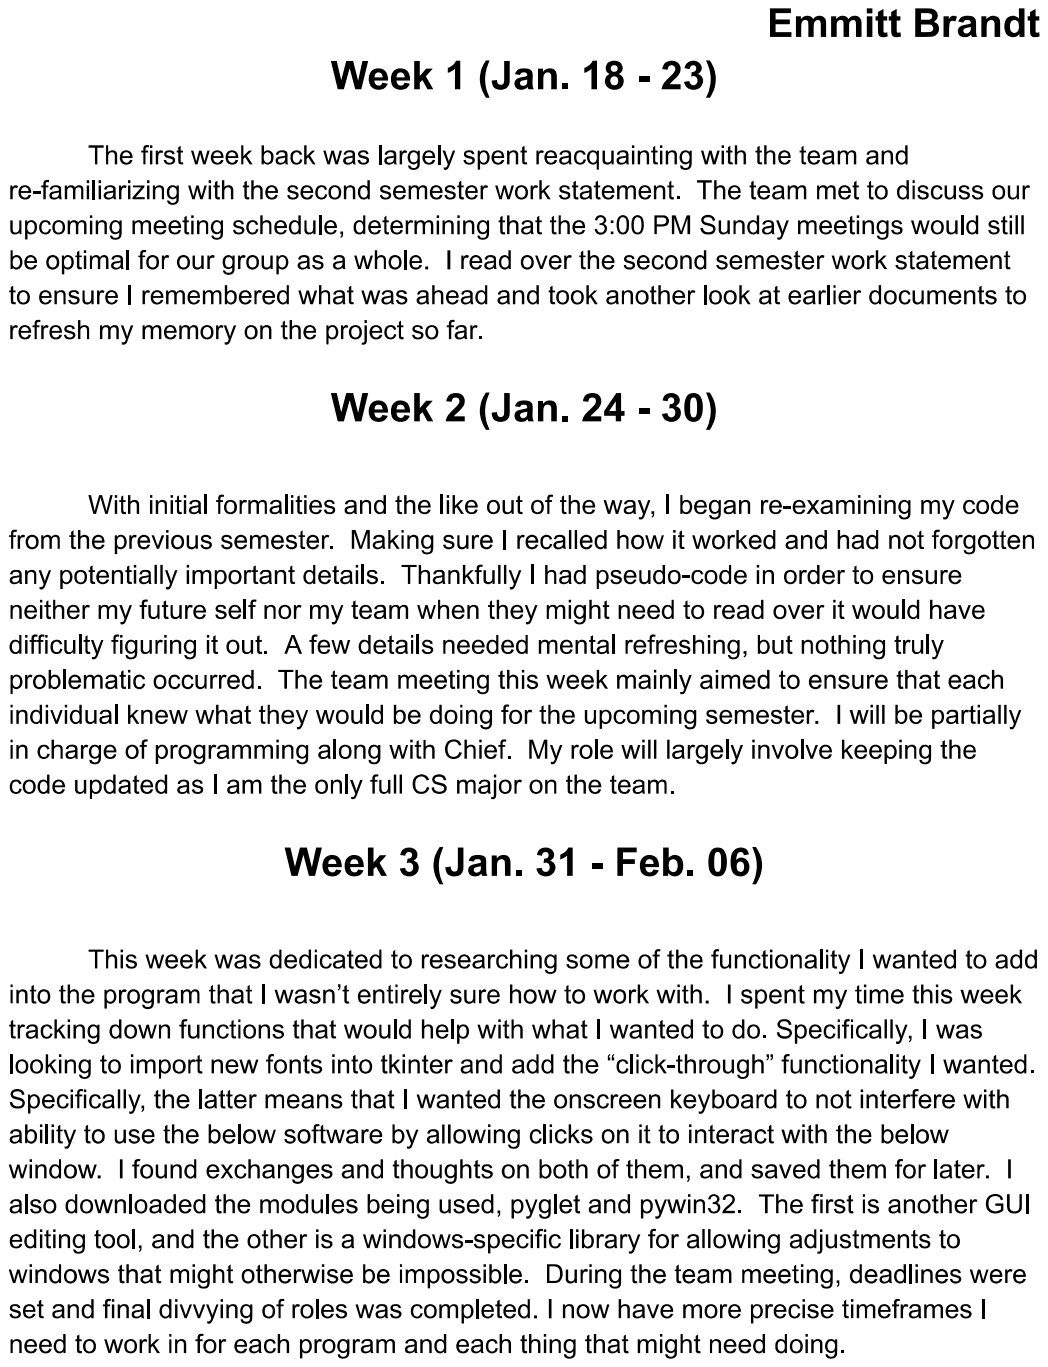
[picture p72: page 1]

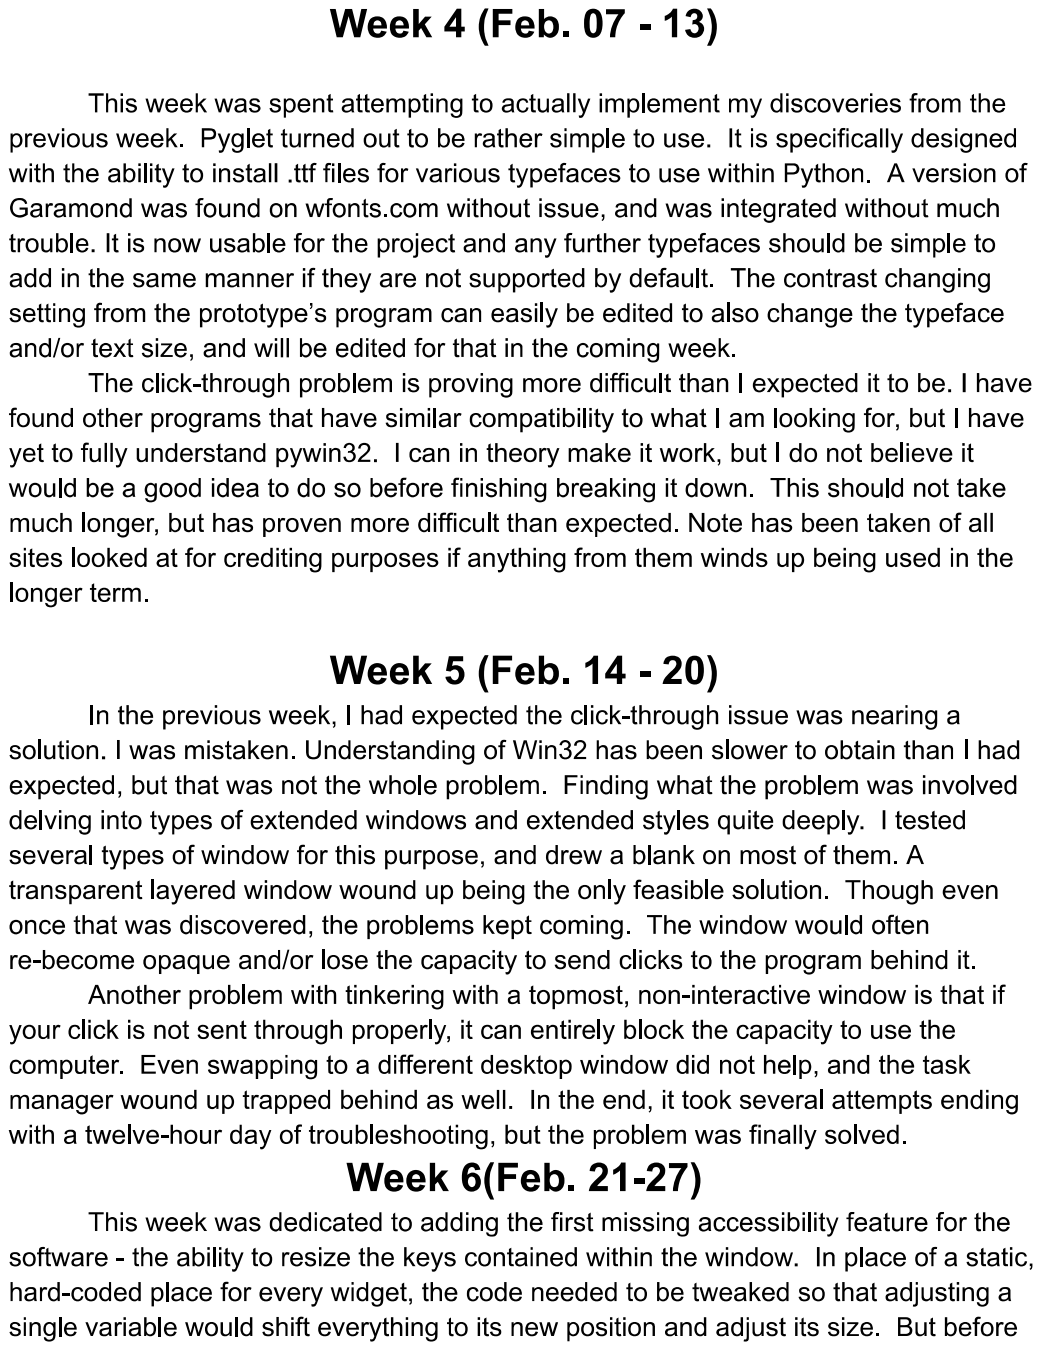
[picture p73: page 2]

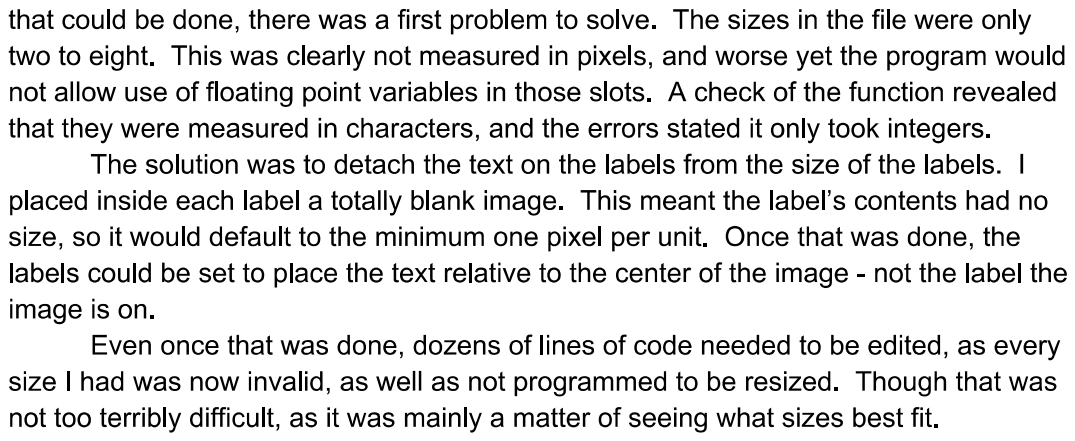
[picture p74: page 3]
