ard-wc/kfpd/Work Packages (Individual)/Individual_Work_Statment_Emmitt.pdf

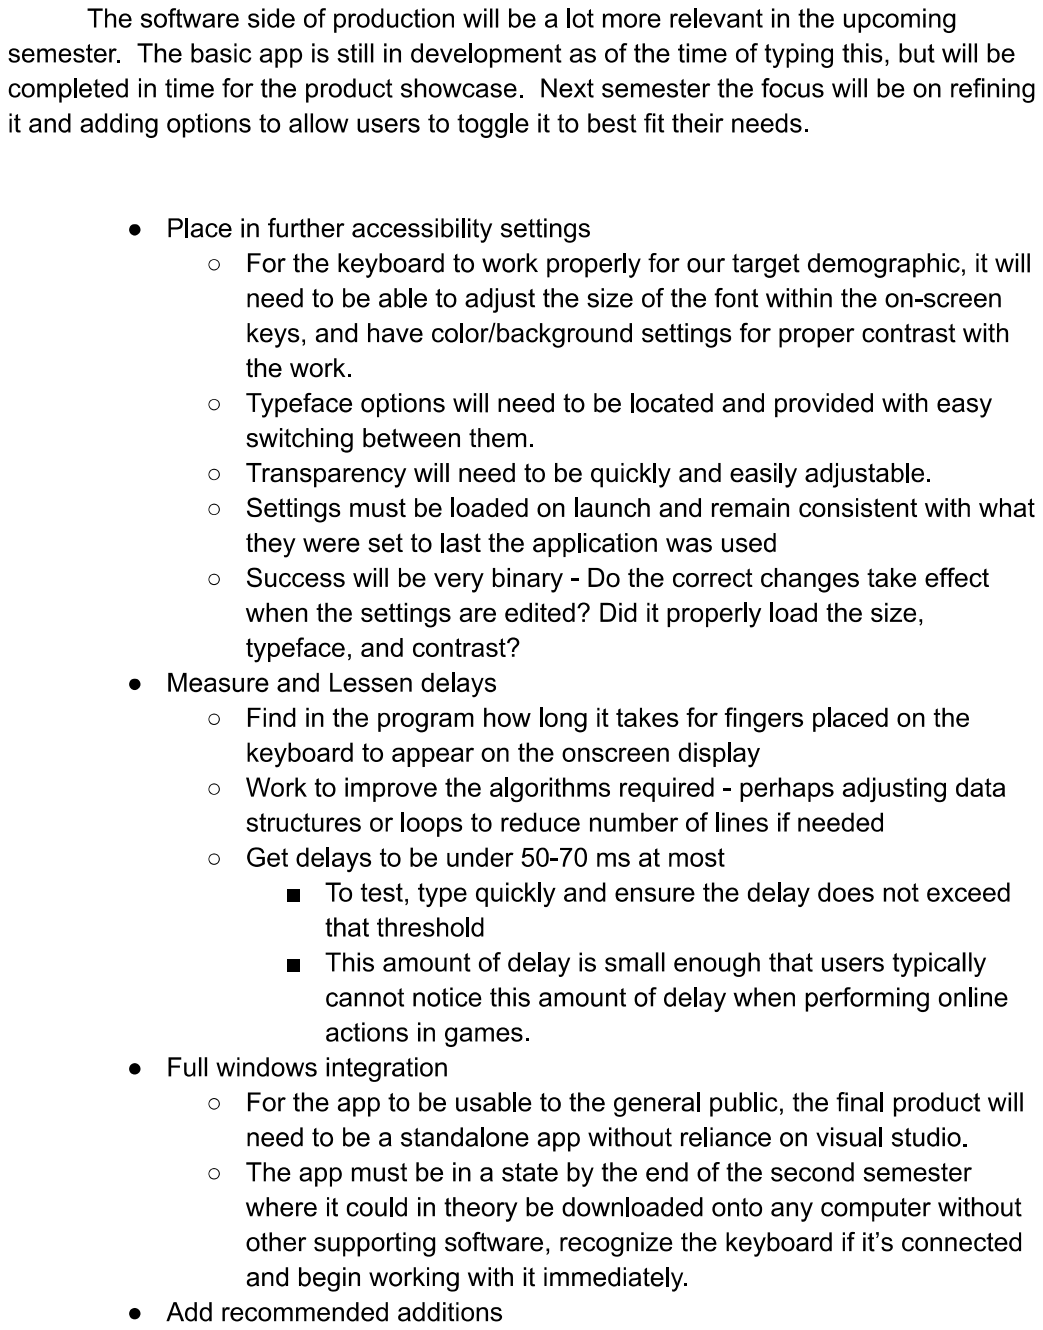
[picture p75: page 1]

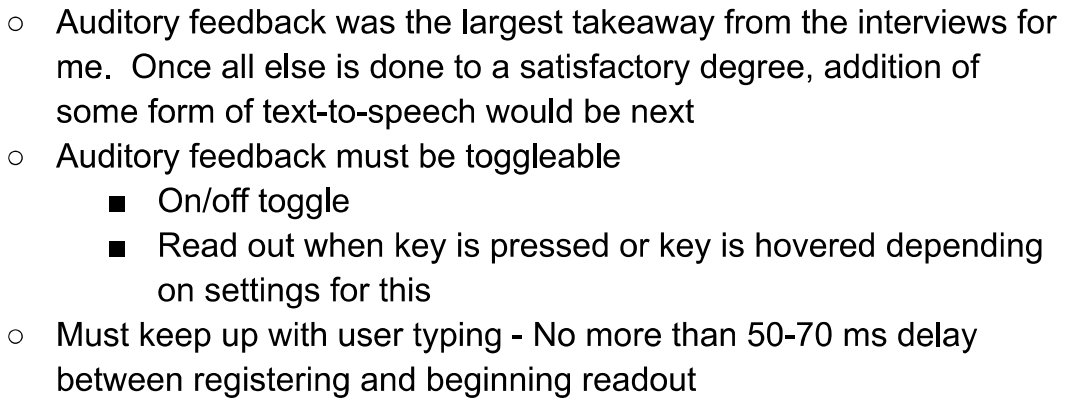
[picture p76: page 2]
