ard-wc/kfpd/(commit log)

2022-02-27 Testing files
    [Combined Data for Testing ADC Counts.xlsx, Test ADC counts just with 25 ohms.csv, Test ADC counts just with 50 ohms.csv, Test ADC counts just with finger2.csv]
2022-02-27 Rename Test ADC counts just with 25 ohms.csv to Test ADC counts just with 25 ohms_Chase.csv
    [Test ADC counts just with 25 ohms_Chase.csv]
2022-02-27 Rename Test ADC counts just with 50 ohms.csv to Test ADC counts just with 50 ohms Chase.csv
    [Test ADC counts just with 50 ohms Chase.csv]
2022-02-27 Rename Test ADC counts just with 50 ohms Chase.csv to Test ADC counts just with 50 ohms_Chase.csv
    [Test ADC counts just with 50 ohms_Chase.csv]
2022-02-27 Rename Test ADC counts just with finger2.csv to Test ADC counts just with finger_Chase.csv
    [Test ADC counts just with finger_Chase.csv]
2022-02-27 HW list
    [Component_List_Slate.xlsx]
2022-03-01 Keyboard Case
